Extentsoftware/Field.Spectrometer/hardware/a1/cad/r1/A1_exploded.png

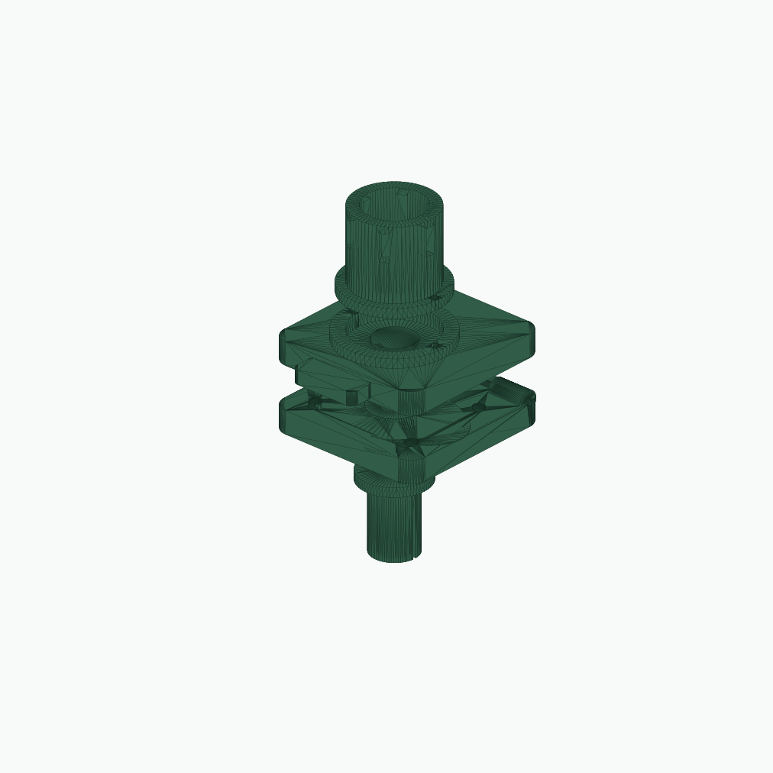
hardware/a1/cad/r1/A1_exploded.png
