Extentsoftware/Field.Spectrometer/hardware/a1/cad/r1/A1_lower_top.png

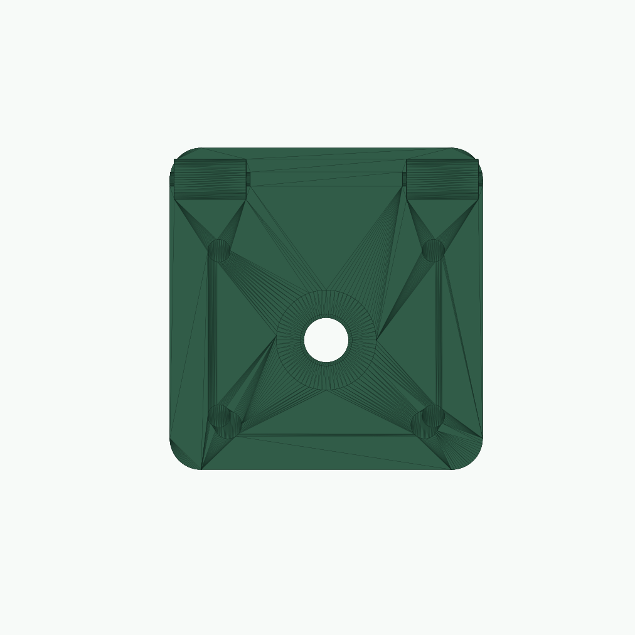
hardware/a1/cad/r1/A1_lower_top.png
