Extentsoftware/Field.Spectrometer/docs/project/BOM.md

# A-1 bill of materials

Revision 2 — 11 October 2026. One transmission-only bench prototype. No orders confirmed. See the [UK purchasing shortlist](UK_PROCUREMENT.md) for exact product links, prices, dimensions, alternatives and outstanding checks. China alternatives are recorded separately in [CHINA_PROCUREMENT.md](CHINA_PROCUREMENT.md); they do not silently replace the UK selections. These are proposed selections; CAD R1 remains review-only.

| Part ID | Proposed item | Build quantity | Supplier | Status |
|---|---|---:|---|---|
| A1-001 | HYD1 fibre kit + development board + TTL–RS485 | 1 kit | S01 | USD 359 historical quote; contents/drawings/power pending |
| A1-002 | 600 µm SMA905 fibre | 1 | S07 / S04 | Anglia range conflict; Edmund alternative; check kit inclusion first |
| A1-003 | Adjustable SMA905 collimator | 1 | S07 / S04 | Anglia 6 mm lens candidate; external body drawing pending |
| A1-004A | MR8 6 V 10 W lamp | Alternative only | S02 | Historical lead; reflector performance unresolved |
| A1-004B | G4 M42 6 V 10 W capsule | 1 | S03 | Proposed bench choice, £7.57 inc VAT; source head redesign |
| A1-005 | K507K ceramic G4 holder | 1 | S13 | Panel cutout known; body/panel thickness and VAT check |
| A1-006 | Edmund 63-224 silica diffuser | 1 | S04 | 12.5 × 1.6 mm; does not fit provisional R1 seat |
| A1-007 | Black silicone leaf gaskets | 2 | S12 | Cut from 0.8 mm stock; request small offcut; force test |
| A1-008 | Metal/ceramic lamp support and thermal barrier | 1 set | S14 + fabrication | Raw aluminium priced; completed thermal assembly unquoted |
| A1-009 | Pololu D30V30F6 6 V regulator | 1 | S08 | Bench candidate; verify startup, ripple and temperature |
| A1-010 | Lamp enable control | 1 arrangement | Regulator EN + wiring | Separate automatic driver deferred; control detail pending |
| A1-011 | Mean Well GST60A12-P1J + UK C13 lead | 1 each | S08 | Lamp branch only; not a confirmed HYD1 supply |
| A1-012 | USB–RS485 interface | 0–1 | S09 / S08 | FTDI candidate; Waveshare isolated alternative sold out; kit/pinout check |
| A1-013 | 3 mm metal hinge pin | 1 cut piece | S11 | Buy 333 mm rod; final length/retention pending |
| A1-014 | 6 × 3 mm N42 magnets | 4 | S10 | Buy pack 20; validate closure and retention |
| A1-015 | M3 screws/inserts | 1 set | S08 | Pack/assortment priced; dimensions and exact usage pending |
| A1-016 | Wiring/connectors/strain relief | 1 set | S08 / S11 / S15 | Wire and GX12-3 candidate; jack ratings and remaining accessories pending |
| A1-017 | Internal black optical lining | 1 allowance | S16 | Cool-side flock candidate; exact option and performance unconfirmed |
| A1-018 | Printed jaws/cartridges | 1 set | Existing stock / S17 | PETG for cool fit prototypes; R2 required; print labour uncosted |
| A1-019 | Enclosure and board mounts | 1 set | S09 | Hammond 1591ESBK candidate, 191 × 110 × 61 mm overall; fit check |
| A1-020 | Dark/open-path reference fixtures | 1 set | Custom | Design and repeatability checks pending |
| A1-021 | Sensor power rail, fuse/protection and thermal cutoff | 1 set | To select | Added omission; depends on board input/inrush/thermal design |

## Cost and inventory rules

Unknown costs are not zero. Do not add mutually exclusive lamp, fibre or interface alternatives together. Buy quantities may exceed build usage. VAT, stock and delivery require checkout confirmation; keep GBP and USD separate. No complete prototype total is issued until held/custom items are resolved. Existing printer, filament and electronics inventory has not been verified.

Battery, display/controller, reflectance and cuvette parts belong to later prototypes, not this purchase list. Purchasing hardware does not validate nutrient estimates or replace laboratory calibration.
