Extentsoftware/Field.Spectrometer/hardware/a1/cad/r1/A1_assembly.3mf

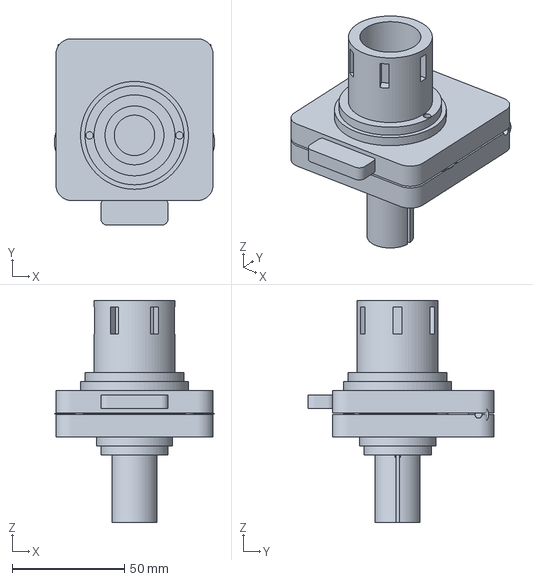
[picture p8: CAD file, 2026-10-11]
hardware/a1/cad/r1/A1_assembly.3mf
71.4 x 83.0 x 98.8 mm
