Extentsoftware/Field.Spectrometer/hardware/a1/cad/r1/A1_exploded.stl

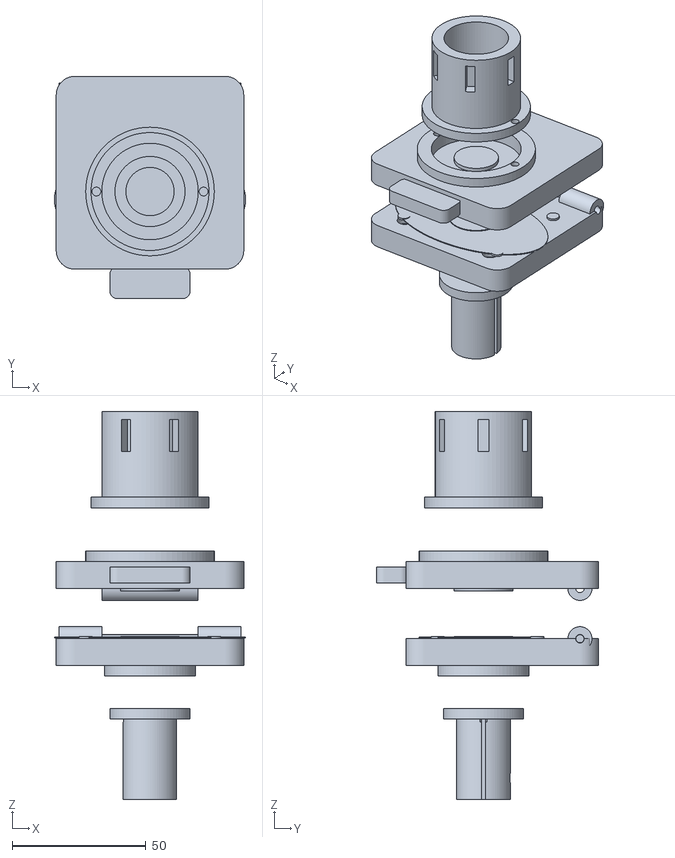
[picture p9: CAD file, 2026-10-11]
hardware/a1/cad/r1/A1_exploded.stl
71.4 x 83.0 x 144.8
