Extentsoftware/Field.Spectrometer/hardware/a1/cad/r1/A1_lower.stl

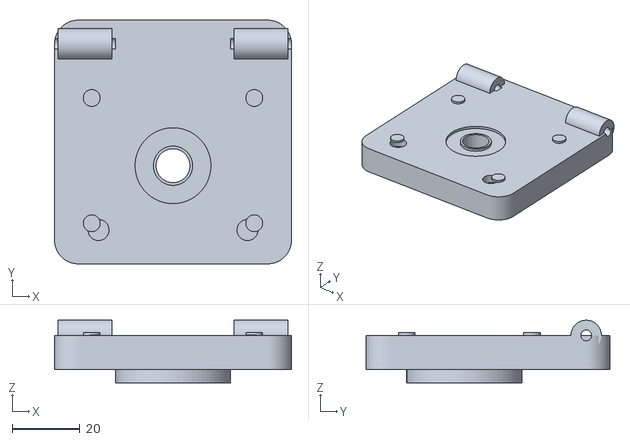
[picture p10: CAD file, 2026-10-11]
hardware/a1/cad/r1/A1_lower.stl
70.0 x 72.0 x 18.5
