Extentsoftware/Field.Spectrometer/hardware/a1/cad/r1/A1_source.stl

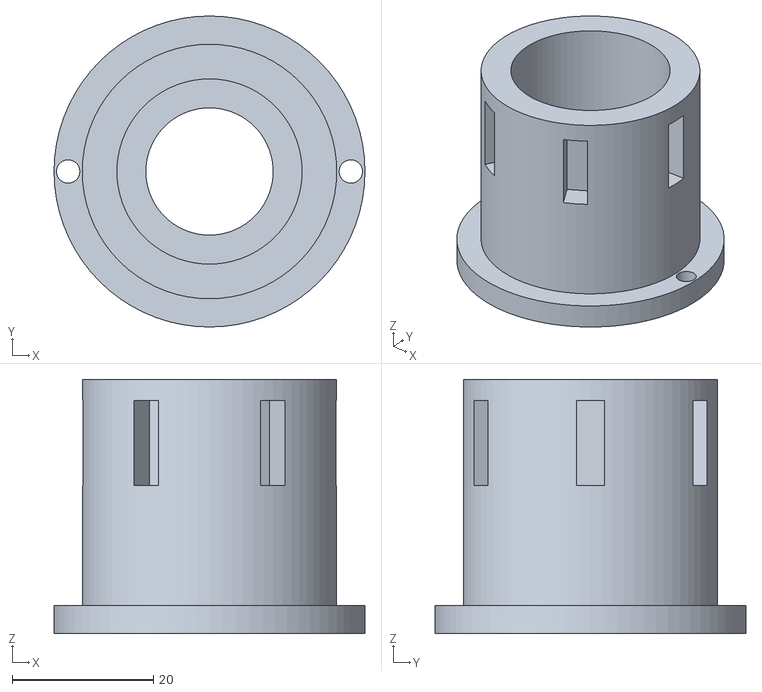
[picture p11: CAD file, 2026-10-11]
hardware/a1/cad/r1/A1_source.stl
44.0 x 44.0 x 36.0
