Extentsoftware/Field.Spectrometer/hardware/a1/cad/r1/A1_collector.stl

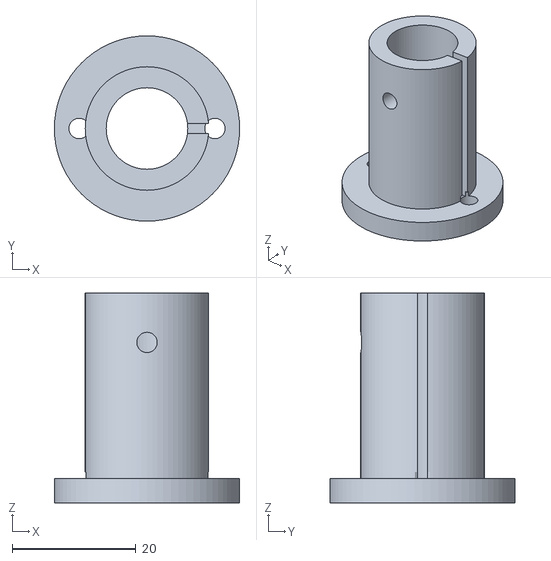
[picture p12: CAD file, 2026-10-11]
hardware/a1/cad/r1/A1_collector.stl
30.0 x 30.0 x 34.0
