Extentsoftware/Field.Spectrometer/hardware/a1/cad/r1/A1_upper.stl

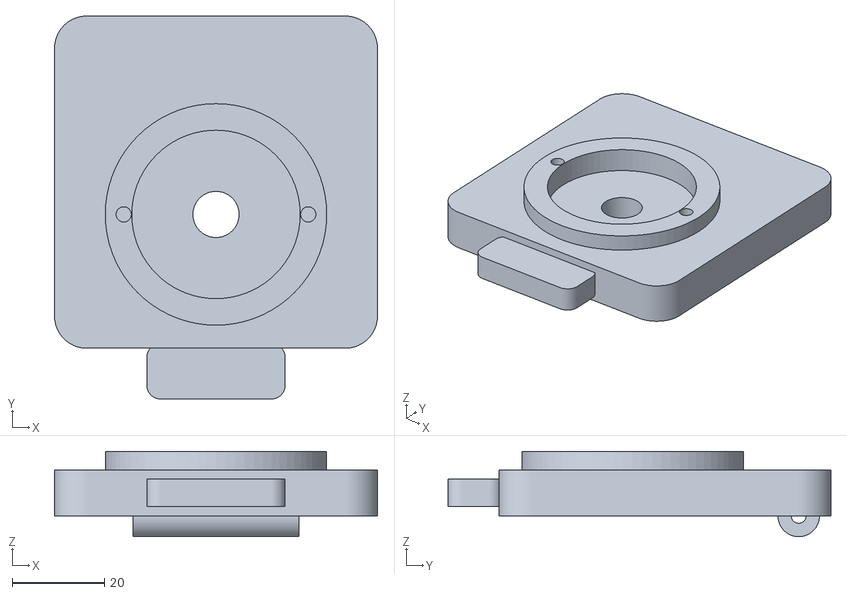
[picture p13: CAD file, 2026-10-11]
hardware/a1/cad/r1/A1_upper.stl
70.0 x 83.0 x 18.5
