Extentsoftware/Field.Spectrometer/hardware/a1/cad/r1/A1_pin.stl

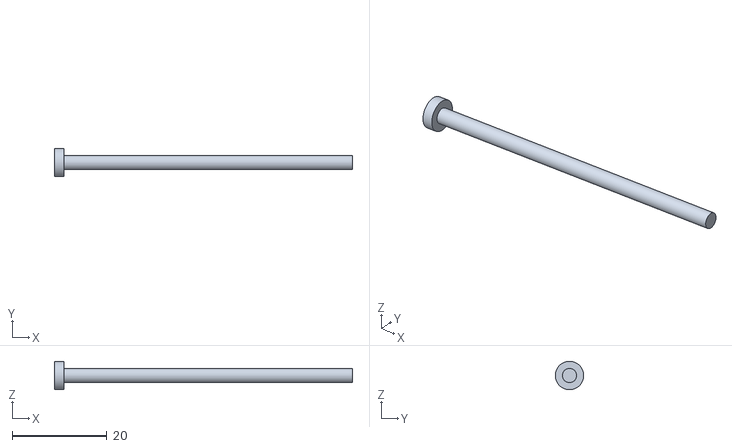
[picture p14: CAD file, 2026-10-11]
hardware/a1/cad/r1/A1_pin.stl
63.0 x 6.00 x 6.00
