Extentsoftware/Field.Spectrometer/(list of files, cad)

Other CAD files:
hardware/a1/cad/r1/A1_assembly.stl
