Extentsoftware/Field.Spectrometer/(commit log)

2026-10-11 Add A-1 CAD review files, BOM, suppliers and project registers
    [A1_assembly.3mf, A1_assembly.stl, A1_collector.stl, A1_dimensions_R1.csv, A1_exploded.stl, A1_leaf_clamp.scad, A1_lower.stl, A1_pin.stl]
2026-10-11 Clarify clamp hardware quantities and optional spring sourcing
